jk1mly/pcb-qrp-tnc/README.md

# pcb-qrp-tnc
おもちゃのトランシーバ用のIC;BK4802Pを使ったモノバンドのFX.25対応TNC付き無線機
TNC部分はM5stamp
