jk1mly/pcb-qrp-tnc/tnc-qrp-sch.pdf

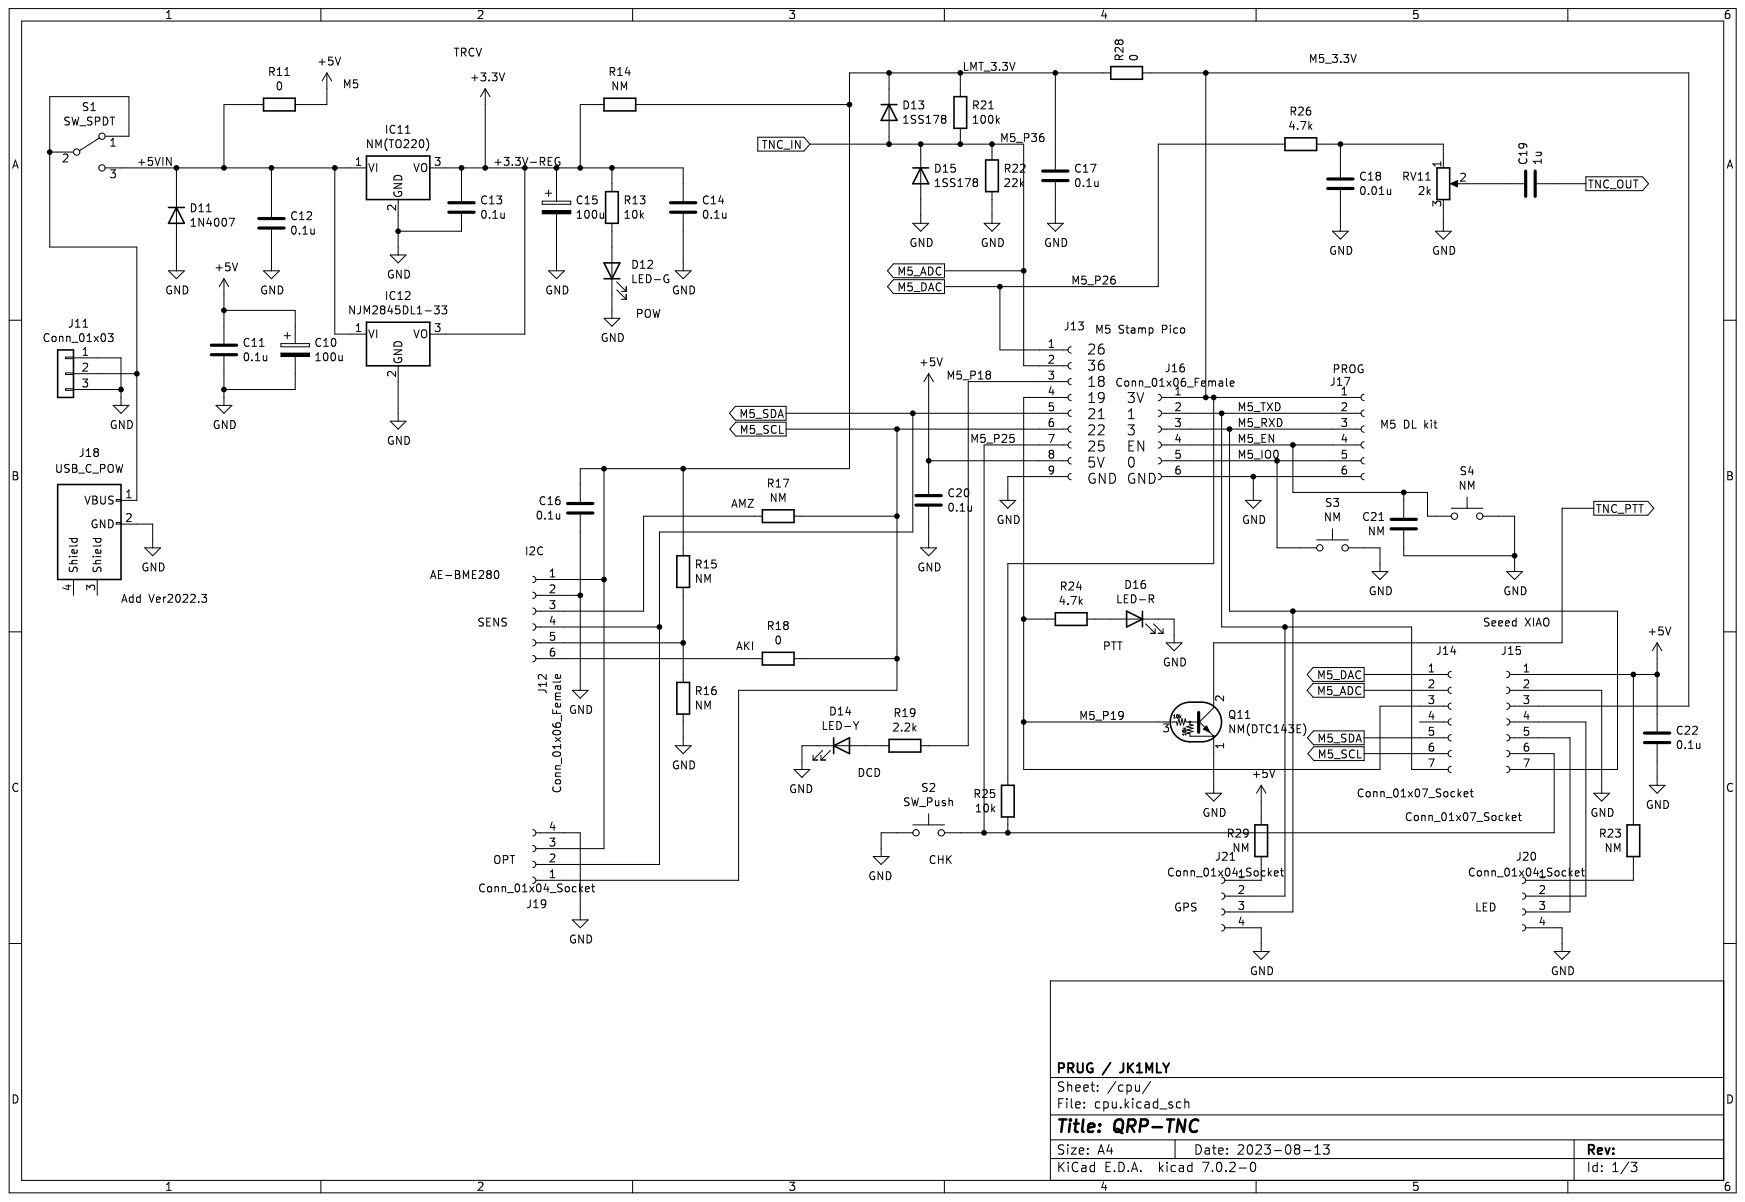
[picture p13: page 1]

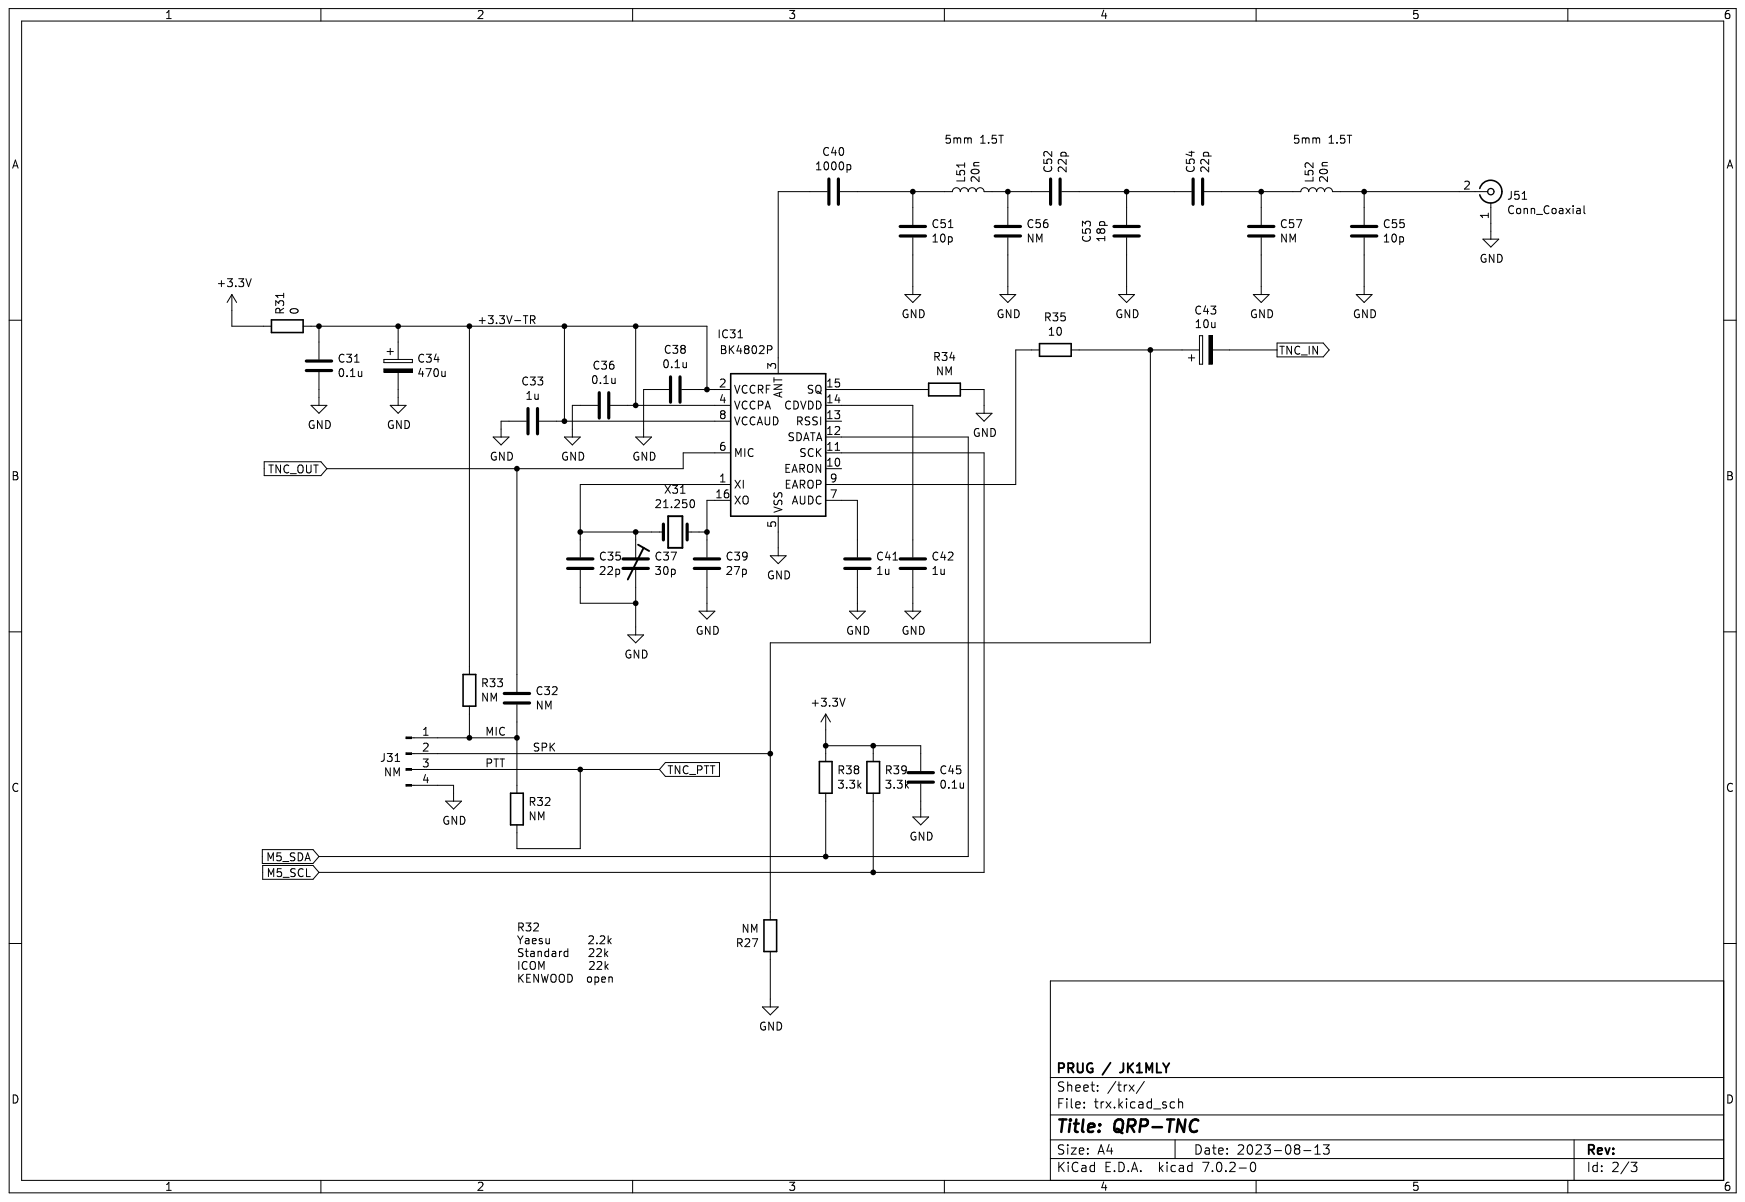
[picture p14: page 2]
