jk1mly/pcb-qrp-tnc/fm-tnc.kicad_pcb

## KiCad design fm-tnc.kicad_pcb (2023-08-13)

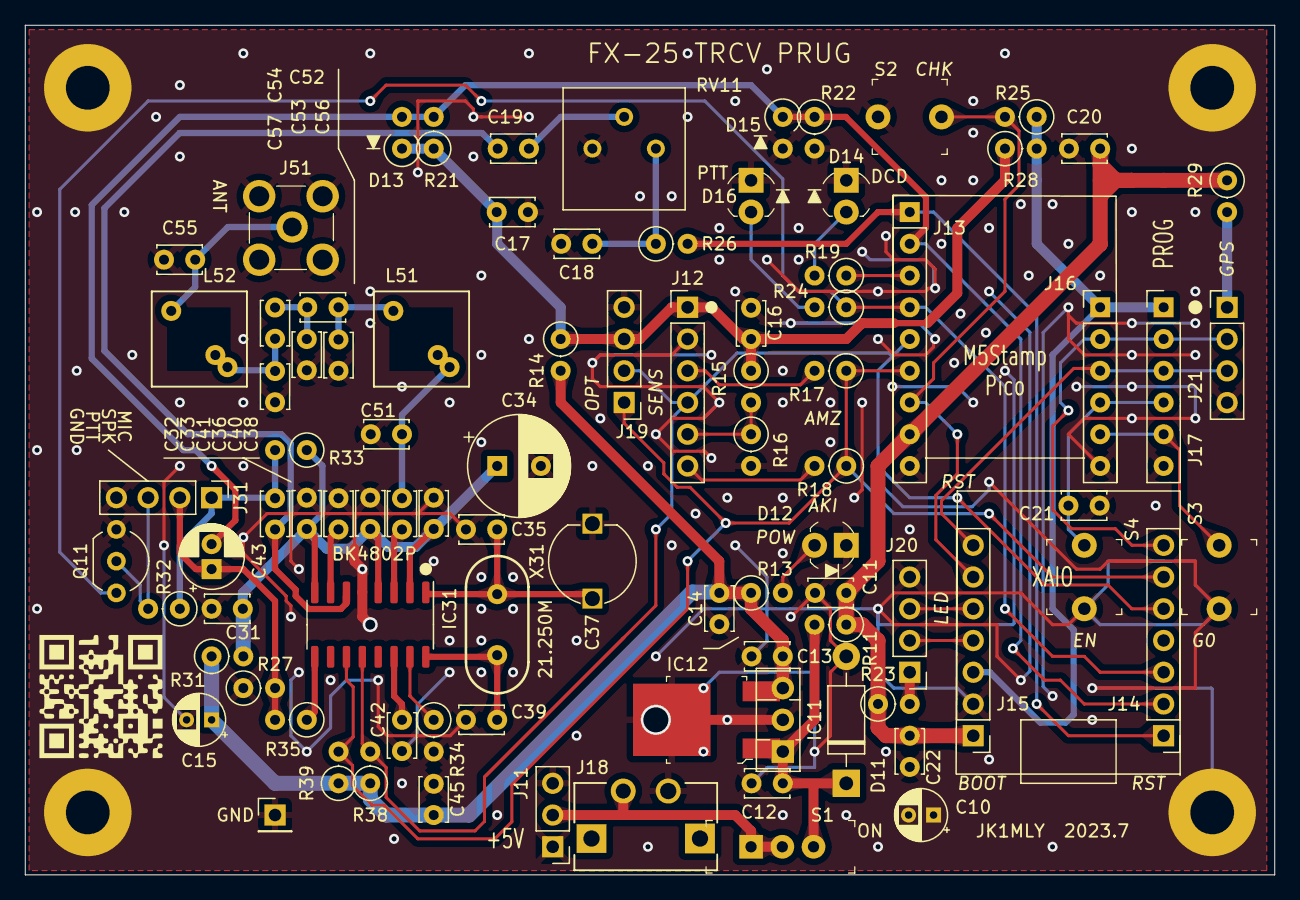
[picture p15: board fm-tnc.kicad_pcb from above]

Board: 2 copper layers, 100.0 x 68.0 mm, 94 parts (0 on the bottom side), 47 nets.

Parts:
C10, C15: 100u; CP_Radial_D4.0mm_P2.00mm
C11, C12, C13, C14, C16, C17, C20, C22, C31, C36, C38, C45: 0.1u; C_Disc_D3.4mm_W2.1mm_P2.50mm
C18: 0.01u; C_Disc_D3.4mm_W2.1mm_P2.50mm
C19, C33, C41, C42: 1u; C_Disc_D3.4mm_W2.1mm_P2.50mm
C21, C32, C56, C57: NM; C_Disc_D3.4mm_W2.1mm_P2.50mm
C34: 470u; CP_Radial_D8.0mm_P3.50mm
C35, C52, C54: 22p; C_Disc_D3.4mm_W2.1mm_P2.50mm
C37: 10p; C_TRIM_P6.00mm
C39: 33p; C_Disc_D3.4mm_W2.1mm_P2.50mm
C40: 1000p; C_Disc_D3.4mm_W2.1mm_P2.50mm
C43: 10u; CP_Radial_D5.0mm_P2.00mm
C51, C55: 10p; C_Disc_D3.4mm_W2.1mm_P2.50mm
C53: 18p; C_Disc_D3.4mm_W2.1mm_P2.50mm
D11: 1N4007; D_DO-41_SOD81_P10.16mm_Horizontal
D12: LED-G; LED_3mm_Radial
D13, D15: 1SS178; D_A-405_P2.54mm_Vertical_AnodeUp
D14: LED-Y; LED_3mm_Radial
D16: LED-R; LED_3mm_Radial
IC11: NM(TO220); TO-126-3_Vertical
IC12: NJM2845DL1-33; TO-252-3
IC31: BK4802P; SO-16_3.9x9.9mm_P1.27mm
J11: Conn_01x03; PinHeader_1x03_P2.54mm_Vertical
J12, J16, J17: Conn_01x06_Female; PinHeader_1x06_P2.54mm_Vertical
J13: Conn_01x09_Female; PinHeader_1x09_P2.54mm_Vertical
J14, J15: Conn_01x07_Socket; PinHeader_1x07_P2.54mm_Vertical
J18: USB_C_POW
J19, J20, J21: Conn_01x04_Socket; PinHeader_1x04_P2.54mm_Vertical
J31: NM; PinHeader_1x04_P2.54mm_Vertical
J51: Conn_Coaxial; RF_SMA_Vertical_5-1814832-1
L51, L52: 20n; coil3_7mm
Q11: NM(DTC143E); TO-92_Inline_Wide
R11, R18, R28, R31: 0; R_Axial_DIN0207_L6.3mm_D2.5mm_P2.54mm_Vertical
R13, R25: 10k; R_Axial_DIN0207_L6.3mm_D2.5mm_P2.54mm_Vertical
R14, R15, R16, R17, R23, R27, R29, R32, R33, R34: NM; R_Axial_DIN0207_L6.3mm_D2.5mm_P2.54mm_Vertical
R19: 2.2k; R_Axial_DIN0207_L6.3mm_D2.5mm_P2.54mm_Vertical
R21: 100k; R_Axial_DIN0207_L6.3mm_D2.5mm_P2.54mm_Vertical
R22: 22k; R_Axial_DIN0207_L6.3mm_D2.5mm_P2.54mm_Vertical
R24, R26: 4.7k; R_Axial_DIN0207_L6.3mm_D2.5mm_P2.54mm_Vertical
R35: 10; R_Axial_DIN0207_L6.3mm_D2.5mm_P2.54mm_Vertical
R38, R39: 3.3k; R_Axial_DIN0207_L6.3mm_D2.5mm_P2.54mm_Vertical
RV11: 2k; Potentiometer_Bourns_3386P_Vertical
S1: SW_SPDT; Switch_Slide_11.6x4mm_EG1218
S2: SW_Push; Switch_2P
S3, S4: NM; Switch_2P
TP1: GND; PinHeader_1x01_P2.54mm_Vertical
TP2, TP3, TP4, TP5: M3; MountingHole_3.5mm_Pad
X31: 21.250; HC49

Connections:
+3V3: C13.1, C14.1, C15.1, C45.1, IC11.3 (VO), IC12.3 (VO), R13.1, R14.2, R31.1, R38.1, R39.1
+5V: C10.1, C11.1, C20.1, C22.1, J13.8, J15.1, R11.1, R23.1, R29.1
/cpu/+5VIN: C12.1, D11.1 (K), IC11.1 (VI), IC12.1 (VI), R11.2, S1.3 (C)
/cpu/LMT_3.3V: C16.1, C17.1, D13.1 (K), J12.1, J19.3, R14.1, R15.1, R21.1, R28.1
/cpu/M5_EN: C21.1, J16.4, J17.4, S4.1
/cpu/M5_IO0: J16.5, J17.5, S3.1
/cpu/M5_P18: J13.3, R19.1
/cpu/M5_P19: J13.4, J14.3, Q11.3 (B), R24.1
/cpu/M5_P25: J13.7, J15.6, R25.2, S2.1
/cpu/M5_RXD: J15.7, J16.3, J17.3, J21.3
/cpu/M5_TXD: J14.7, J16.2, J17.2, J21.2
/trx/+3.3V-TR: C31.1, C33.2, C34.1, C36.2, C38.2, IC31.2 (VCCRF), IC31.4 (VCCPA), IC31.8 (VCCAUD), R31.2, R33.1
/trx/MIC: C32.2, J31.1, R32.1, R33.2
/trx/SPK: C43.1, J31.2, R27.2, R35.2
GND: C10.2, C11.2, C12.2, C13.2, C14.2, C15.2, C16.2, C17.2, C18.2, C20.2, C21.2, C22.2, C31.2, C33.1, C34.2, C35.2, C36.1, C37.2, C38.1, C39.2, C41.2, C42.2, C45.2, C51.2, C53.1, C55.2, C56.2, C57.2, D11.2 (A), D12.1 (K), D14.1 (K), D15.2 (A), D16.1 (K), IC11.2 (GND), IC12.2 (GND), IC31.5 (VSS), J11.1, J11.3, J12.2, J13.9, J15.2, J16.6, J17.6, J18.2 (GND), J19.4, J20.4, J21.4, J31.4, J51.1 (G), Q11.1 (E), R16.2, R22.2, R27.1, R34.2, RV11.3, S2.2, S3.2, S4.2, TP1.1, TP2.1, TP3.1, TP4.1, TP5.1
M5_ADC: C43.2, D13.2 (A), D15.1 (K), J13.2, J14.2, R21.2, R22.1
M5_DAC: J13.1, J14.1, R26.2
M5_SCL: IC31.11 (SCK), J13.6, J14.6, J19.1, R17.1, R18.1, R39.2
M5_SDA: IC31.12 (SDATA), J12.4, J13.5, J14.5, J19.2, R38.2
unnamed: C18.1, R26.1, RV11.1
unnamed: C19.1, RV11.2
unnamed: C40.2, C51.1, L51.1
unnamed: C52.1, C56.1, L51.2
unnamed: C52.2, C53.2, C54.1
unnamed: C54.2, C57.1, L52.1
unnamed: D12.2 (A), R13.2
unnamed: D14.2 (A), R19.2
unnamed: D16.2 (A), R24.2
unnamed: C40.1, IC31.3 (ANT)
unnamed: C41.1, IC31.7 (AUDC)
unnamed: C42.1, IC31.14 (CDVDD)
unnamed: IC31.9 (EAROP), R35.1
unnamed: IC31.15 (SQ), R34.1
unnamed: C35.1, C37.1, IC31.1 (XI), X31.1
unnamed: C39.1, IC31.16 (XO), X31.2
unnamed: J11.2, J18.1 (VBUS), S1.1 (A), S1.2 (B)
unnamed: J12.3, R17.2
unnamed: J12.5, R15.2, R16.1
unnamed: J12.6, R18.2
unnamed: J15.3, J16.1, J17.1, R25.1, R28.2
unnamed: J15.4, J20.2
unnamed: J15.5, J20.3
unnamed: J20.1, R23.2
unnamed: J21.1, R29.2
unnamed: C55.1, J51.2 (S), L52.2
TNC_OUT: C19.2, C32.1, IC31.6 (MIC)
TNC_PTT: J31.3, Q11.2 (C), R32.2
