jk1mly/pcb-qrp-tnc/(threads)

Thread 1 (2024-06-04):

How to place BK4802P in RX or TX mode? It does not have a dedicated TX-RX pin to commute.

raduvas, 2024-06-04:
How to place BK4802P in RX or TX mode? It does not have a dedicated TX-RX pin to commute like BK4802N.

Please help!

You use I2C to place it in RX or TX mode?

Do you have datasheet for BK4802P? I only found one for BK4802N.

jk1mly, 2024-06-05:
BK4802N cannot be switched by hardware.
You can use I2C to change the sending and receiving.
Maybe you can use reg 9 to switch.
I'm the same. I only have BK4802N too.

The software for this TNC is below.
https://github.com/amedes/ESP32TNC

Another example program is below.
https://github.com/jk1mly/fm-trcv/tree/pic1705

raduvas, 2024-06-06:
I already downloaded your examples and in 1-2 months maybe I will make something out of it. I want to build a FM CB receiver for 27.225 Mhz because on this CB channel we get realtime traffic info about accidents, police locations and so on.

 I got a board from Aliexpress like this:
https://www.aliexpress.com/item/1005006451715094.html

I stripped the original microcontroler and the 24C02 memory (wich was full of 0xFF, it didn't contain any data) and I will piggy back an ATMEL AVR to set the BK4802P on the CB channel I want.

Thank you for the info!

jk1mly, 2024-06-07:
I hope it works.
