jk1mly/pcb-qrp-tnc/(commit log)

2022-03-21 qrp-fm試作の反映
    [bpf.kicad_sch, cpu.kicad_sch, fm-tnc.kicad_pcb, fm-tnc.kicad_sch, trx.kicad_sch]
2022-03-21 fm-qrp試作の反映
2022-03-21 old version
    [bpf.sch]
2022-05-03 製作方法
2022-05-03 Add files via upload
    秋月の通販コード追加
    部品表の代わりにxmlファイルを追加
    [bpf.kicad_sch, cpu.kicad_sch, fm-tnc.kicad_sch, trx.kicad_sch]
2022-05-14 バンドパスフィルタ見直し
    [bpf.kicad_sch, cpu.kicad_sch, fm-tnc.kicad_sch, trx.kicad_sch]
